ae-hesham/Temperature-Controlled-DC-Fan-PCB/hardware/schematics/Temperature-Controlled-DC-Fan-PCB_Schematics_BOM.pdf

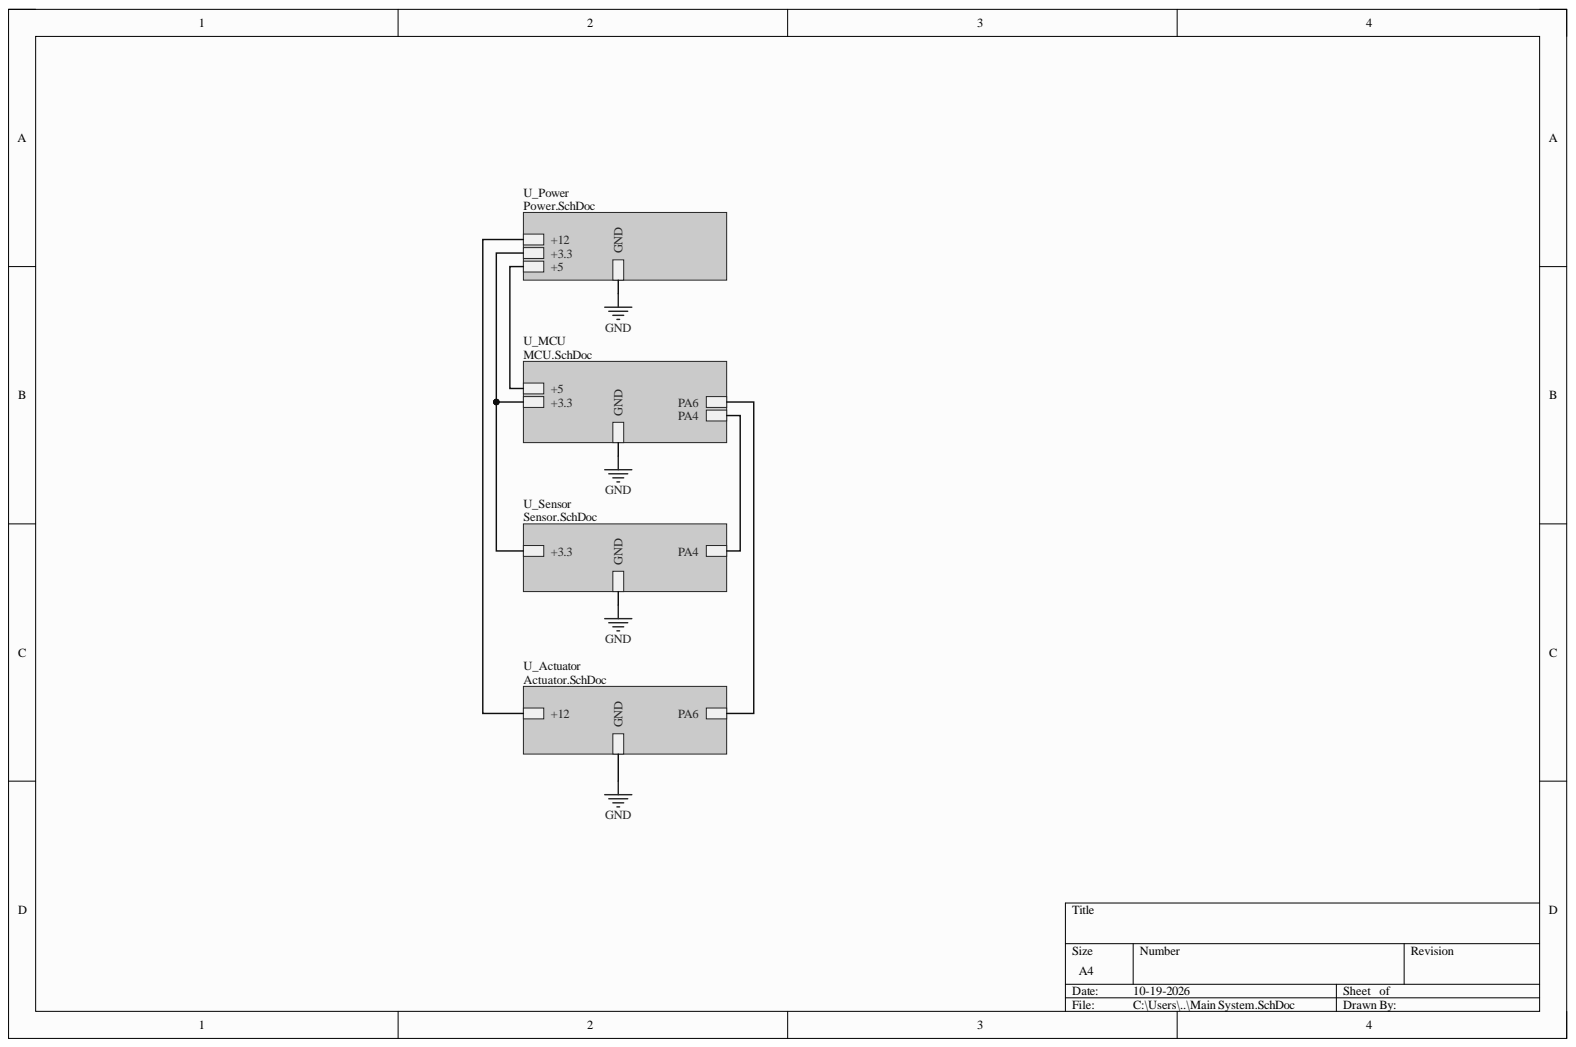
[picture p4: page 1]

Size A4 | Number | Revision

Date: 10-19-2026 | Sheet of
File: C:\Users\..\Main System.SchDoc | Drawn By:

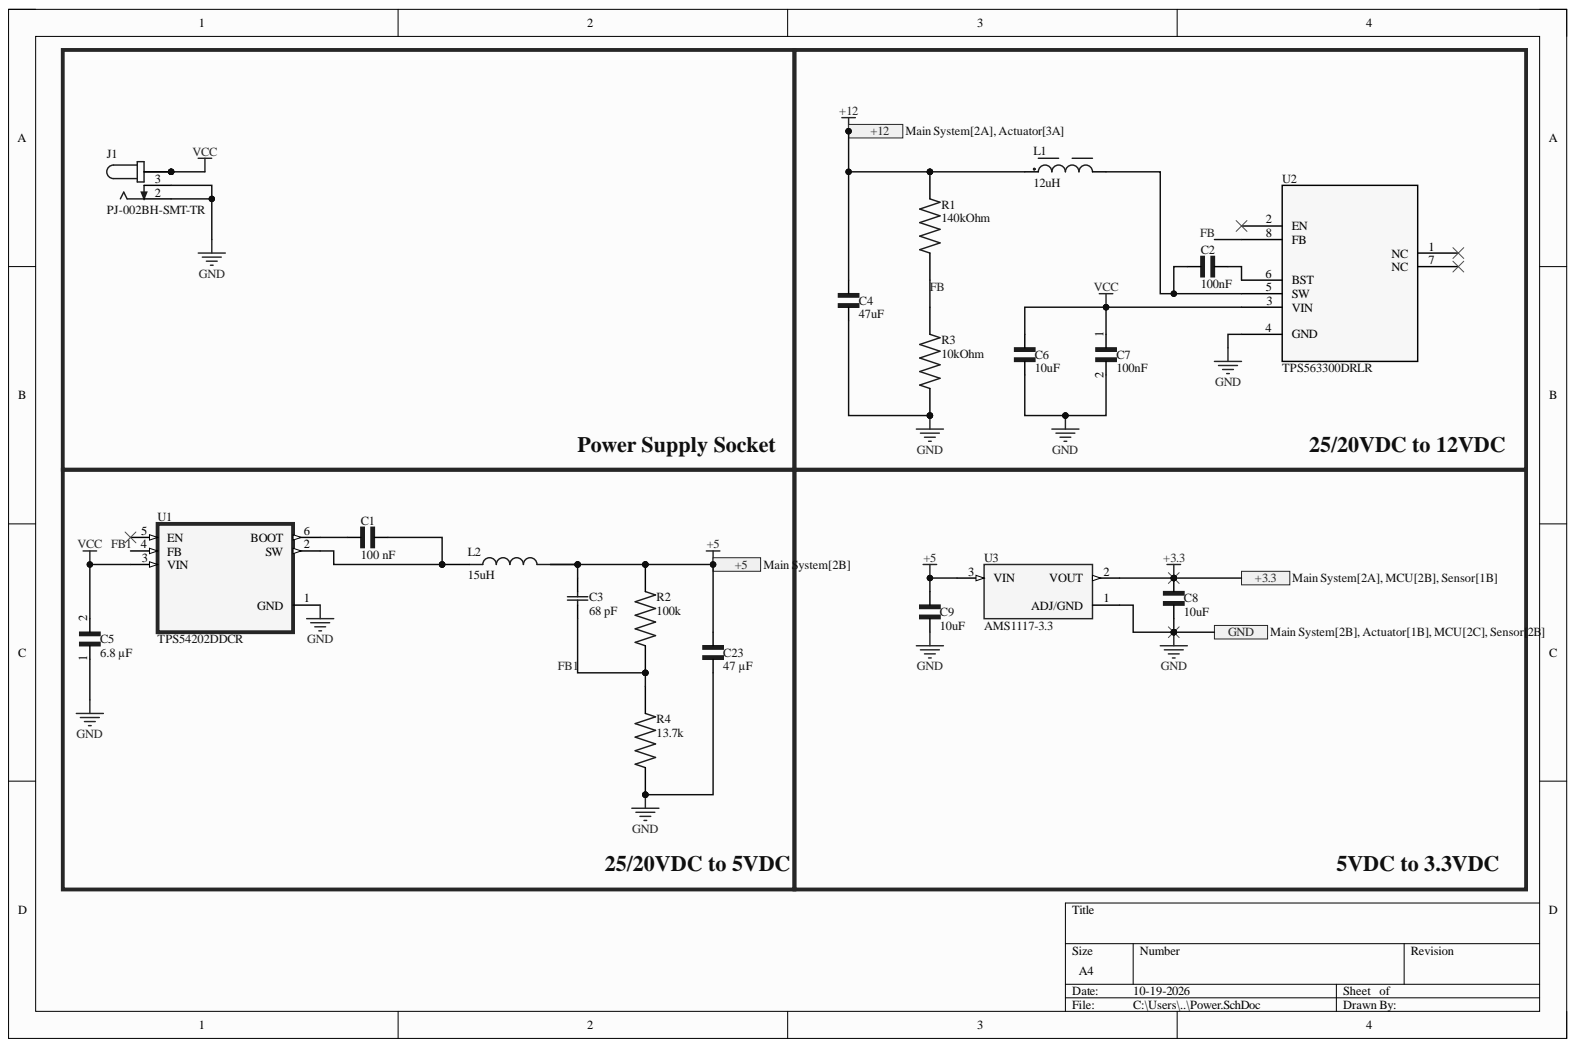
[picture p5: page 2]

Siz e A4 | Numb e r | R evisio n

Da te : 10-19-2 0 2 6 | She et of
File : C:\Use rs\. .\Pow e r . S c hD o c | Dr awn B y :

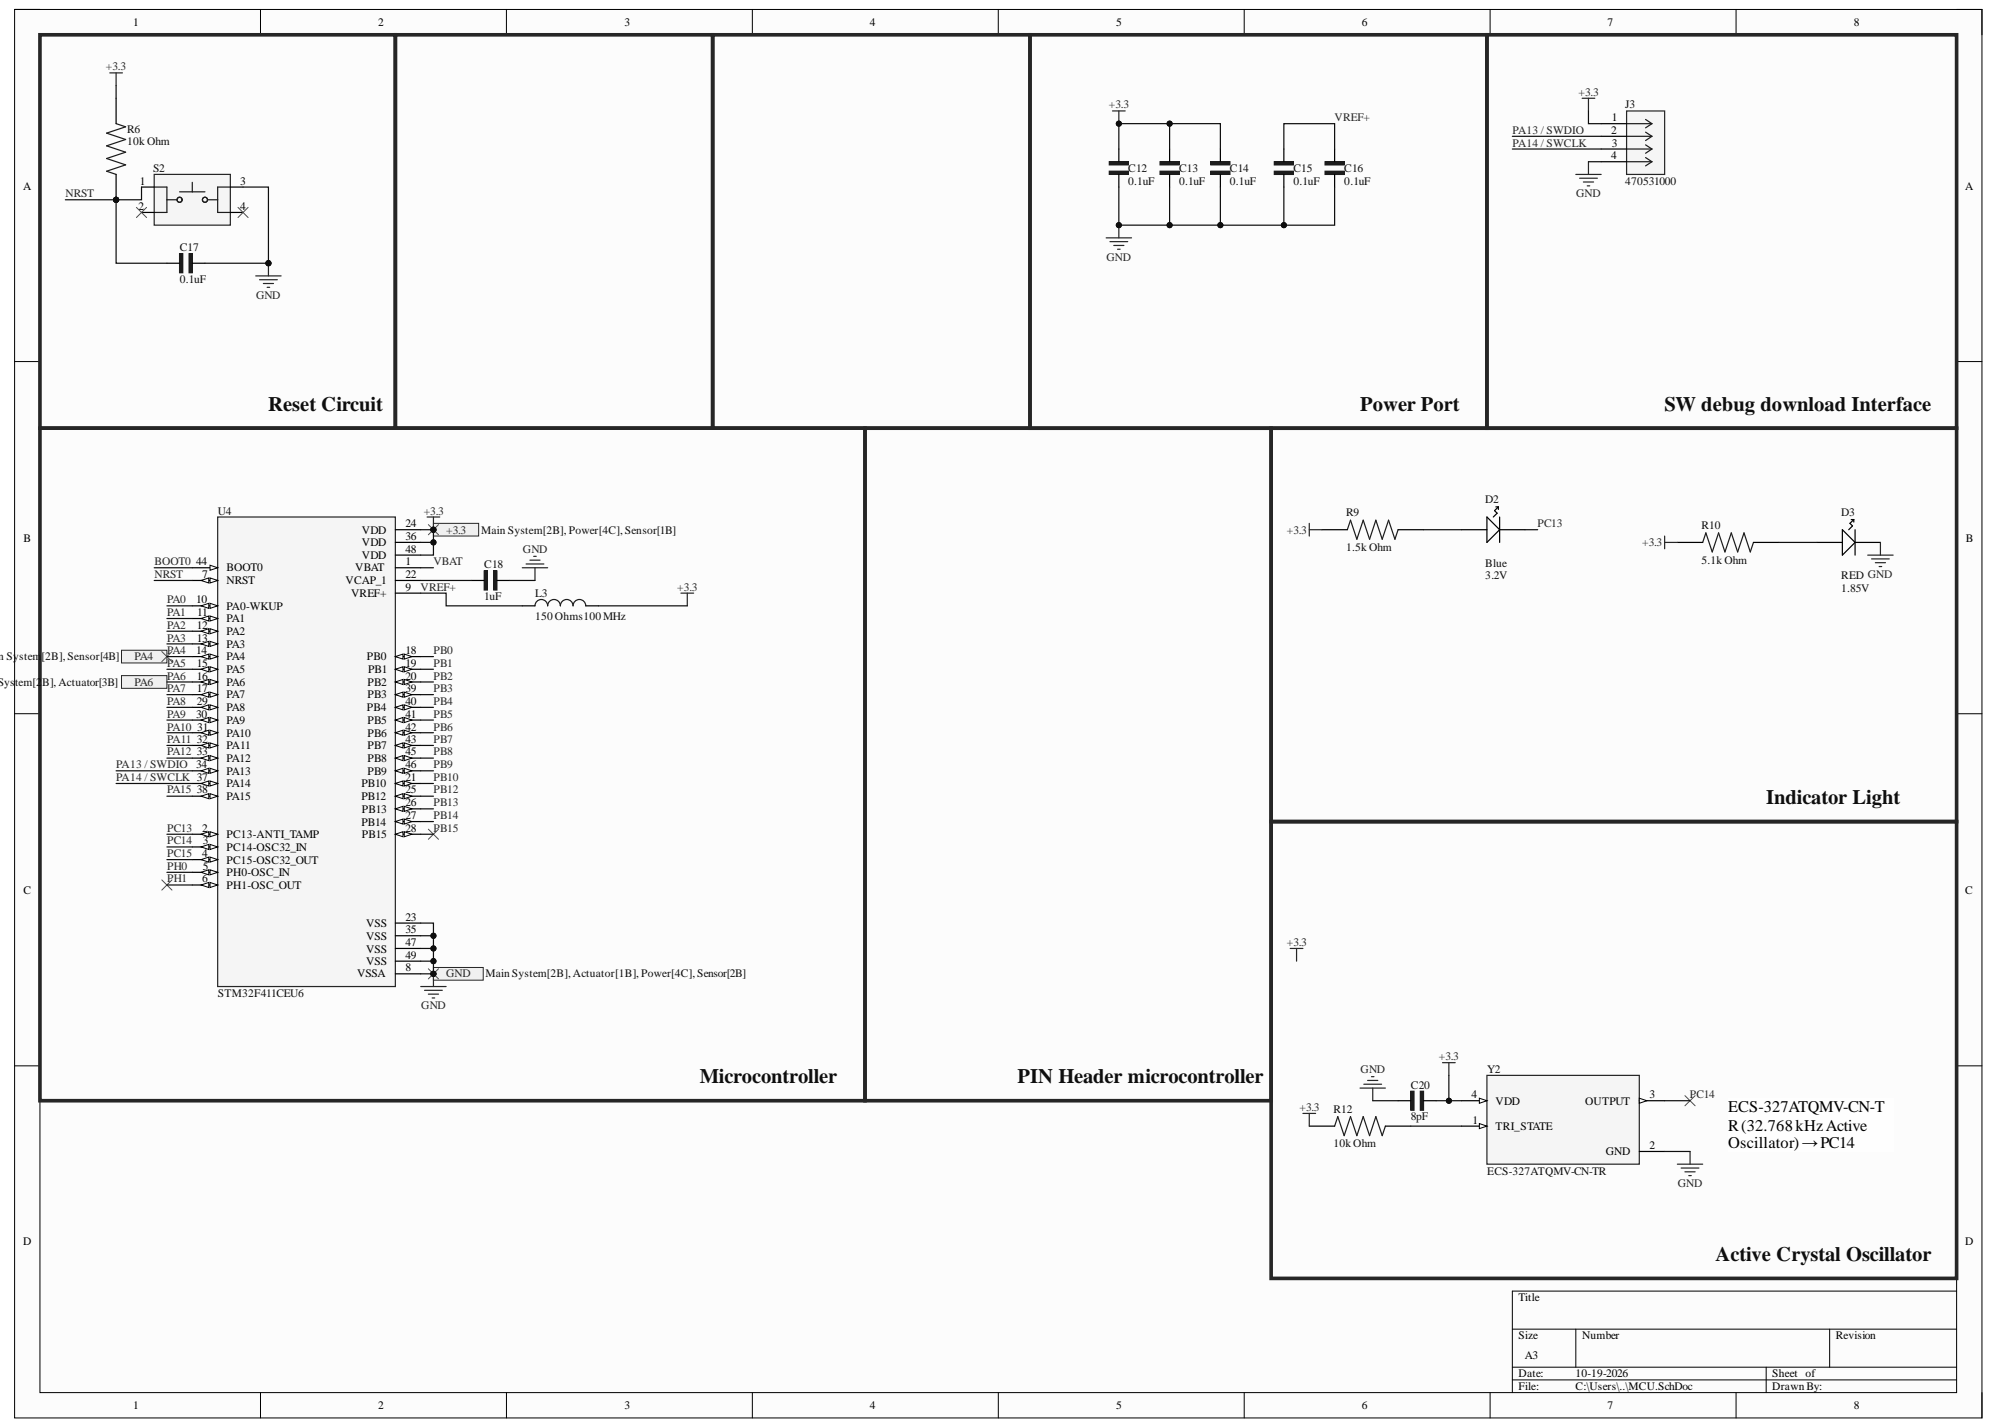
[picture p6: page 3]

SW debug download Interface

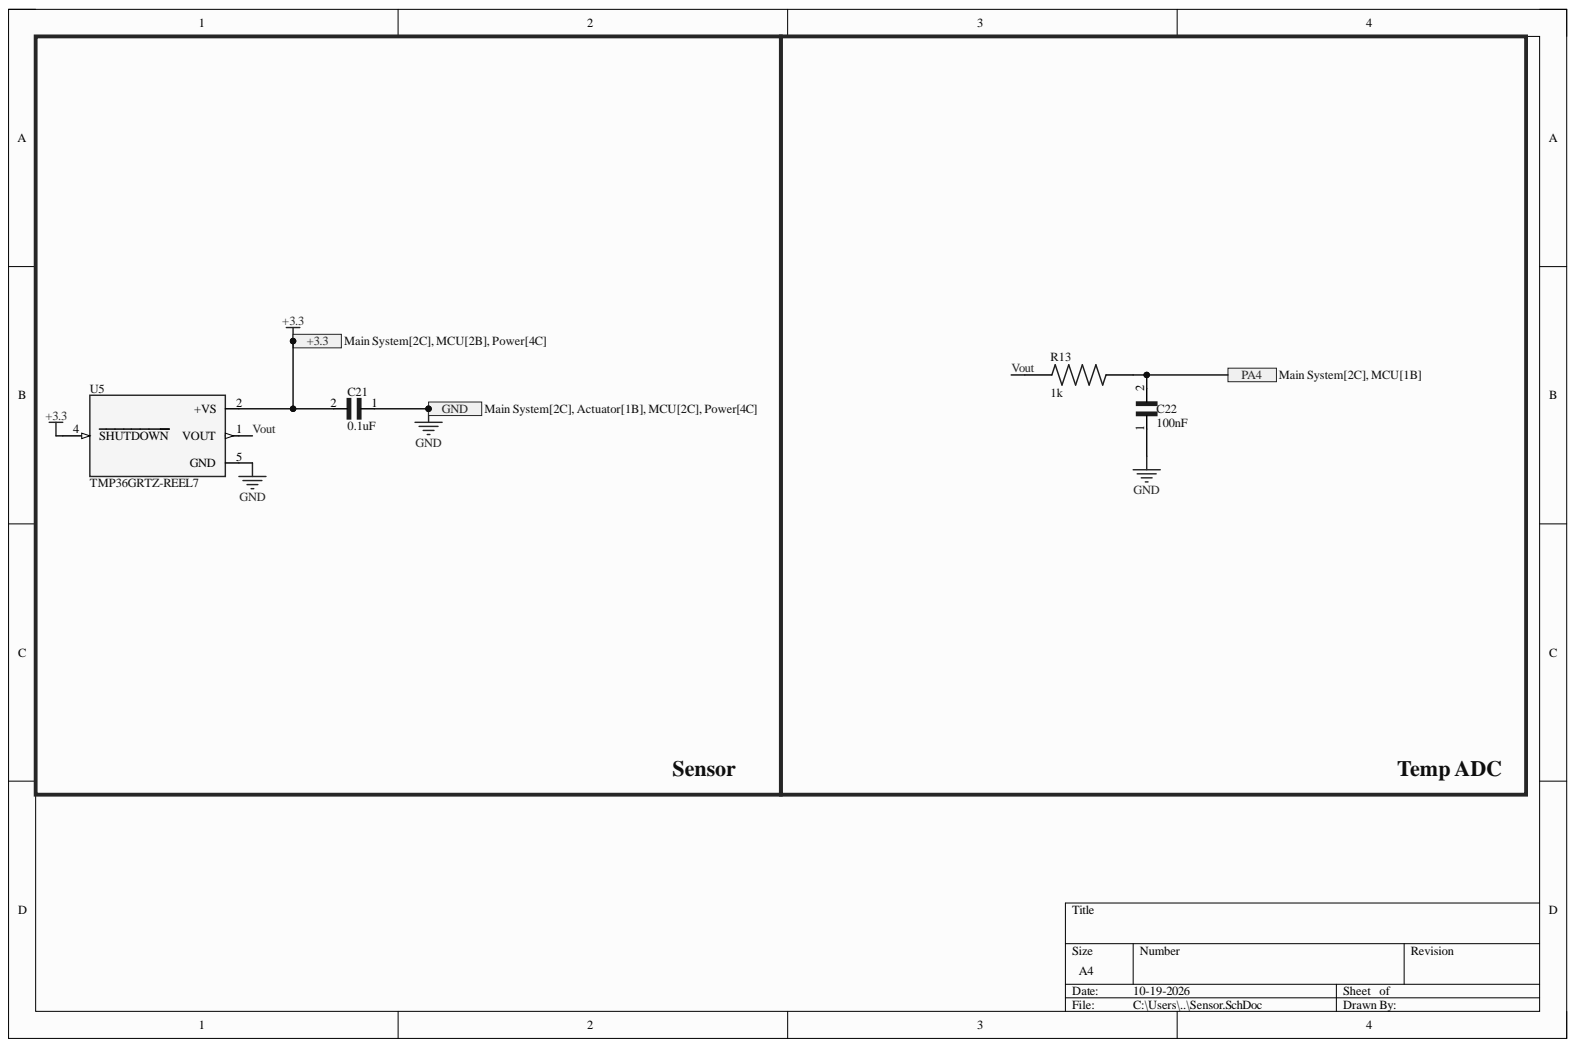
[picture p7: page 4]

Siz e A4 | Numb e r | R evisio n

Da te : 10-19-2 0 2 6 | She et of
File : C:\Use rs\. .\S enso r . S c hD o c | Dr awn B y :

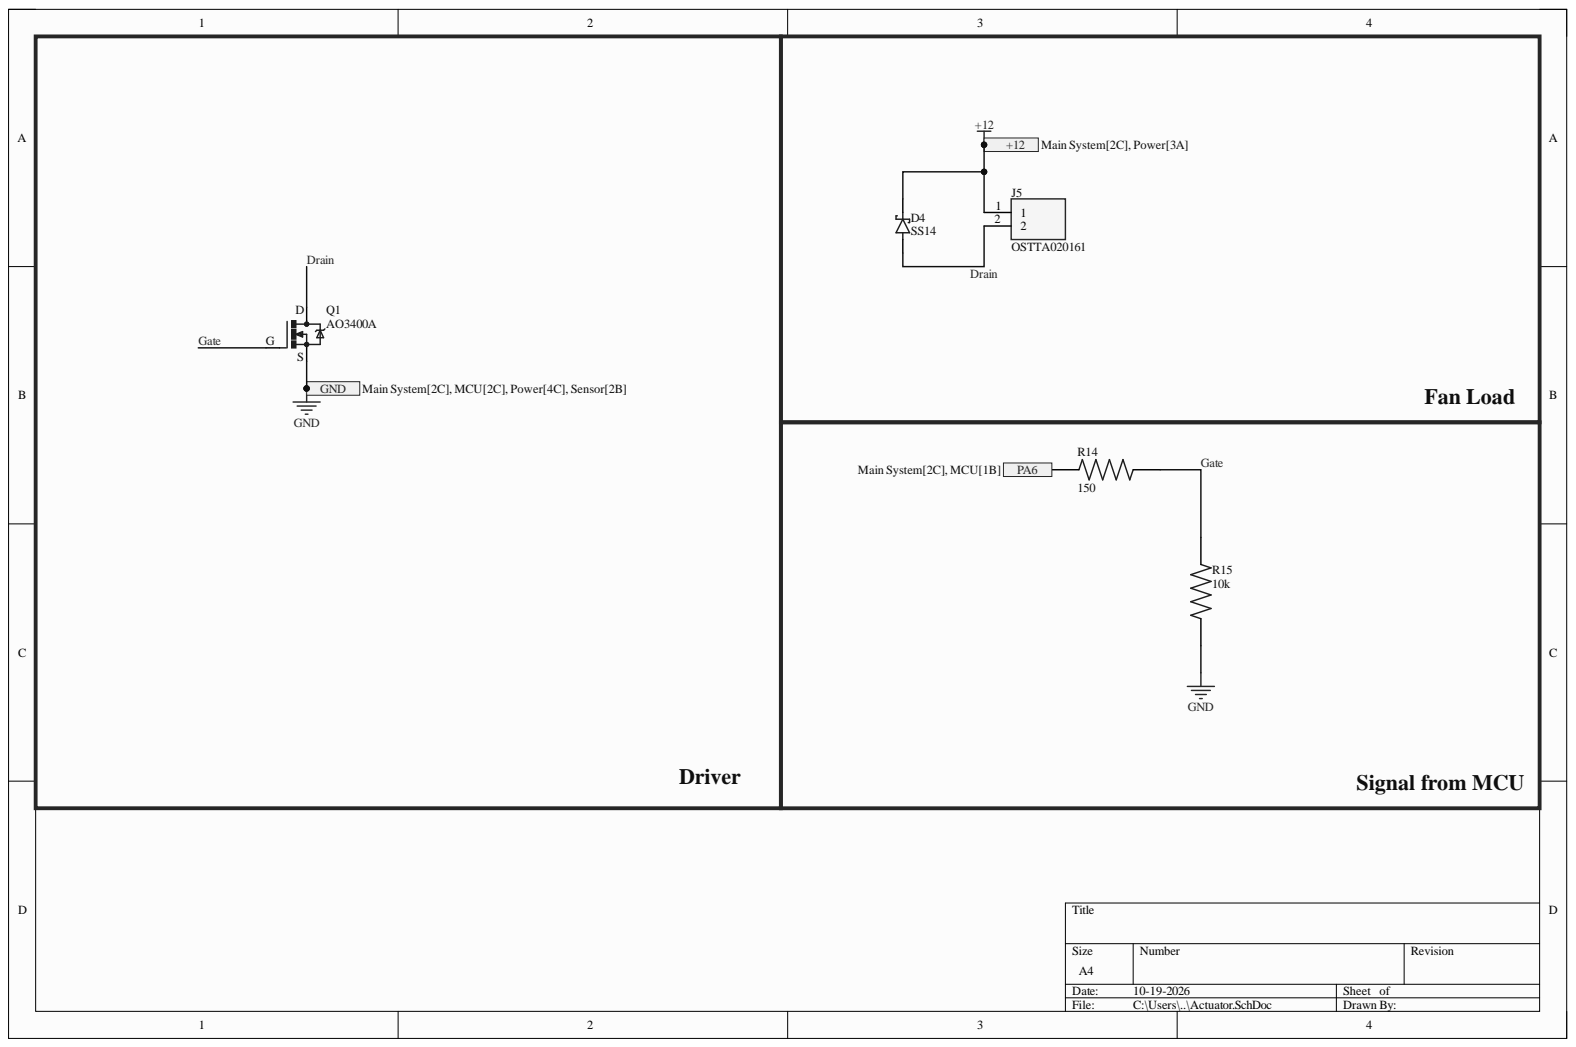
[picture p8: page 5]

Siz e A4 | Numb e r | R evisio n

Da te : 10-19-2 0 2 6 | She et of
File : C:\Use rs\. .\Actua tor . S c hD o c | Dr awn B y :

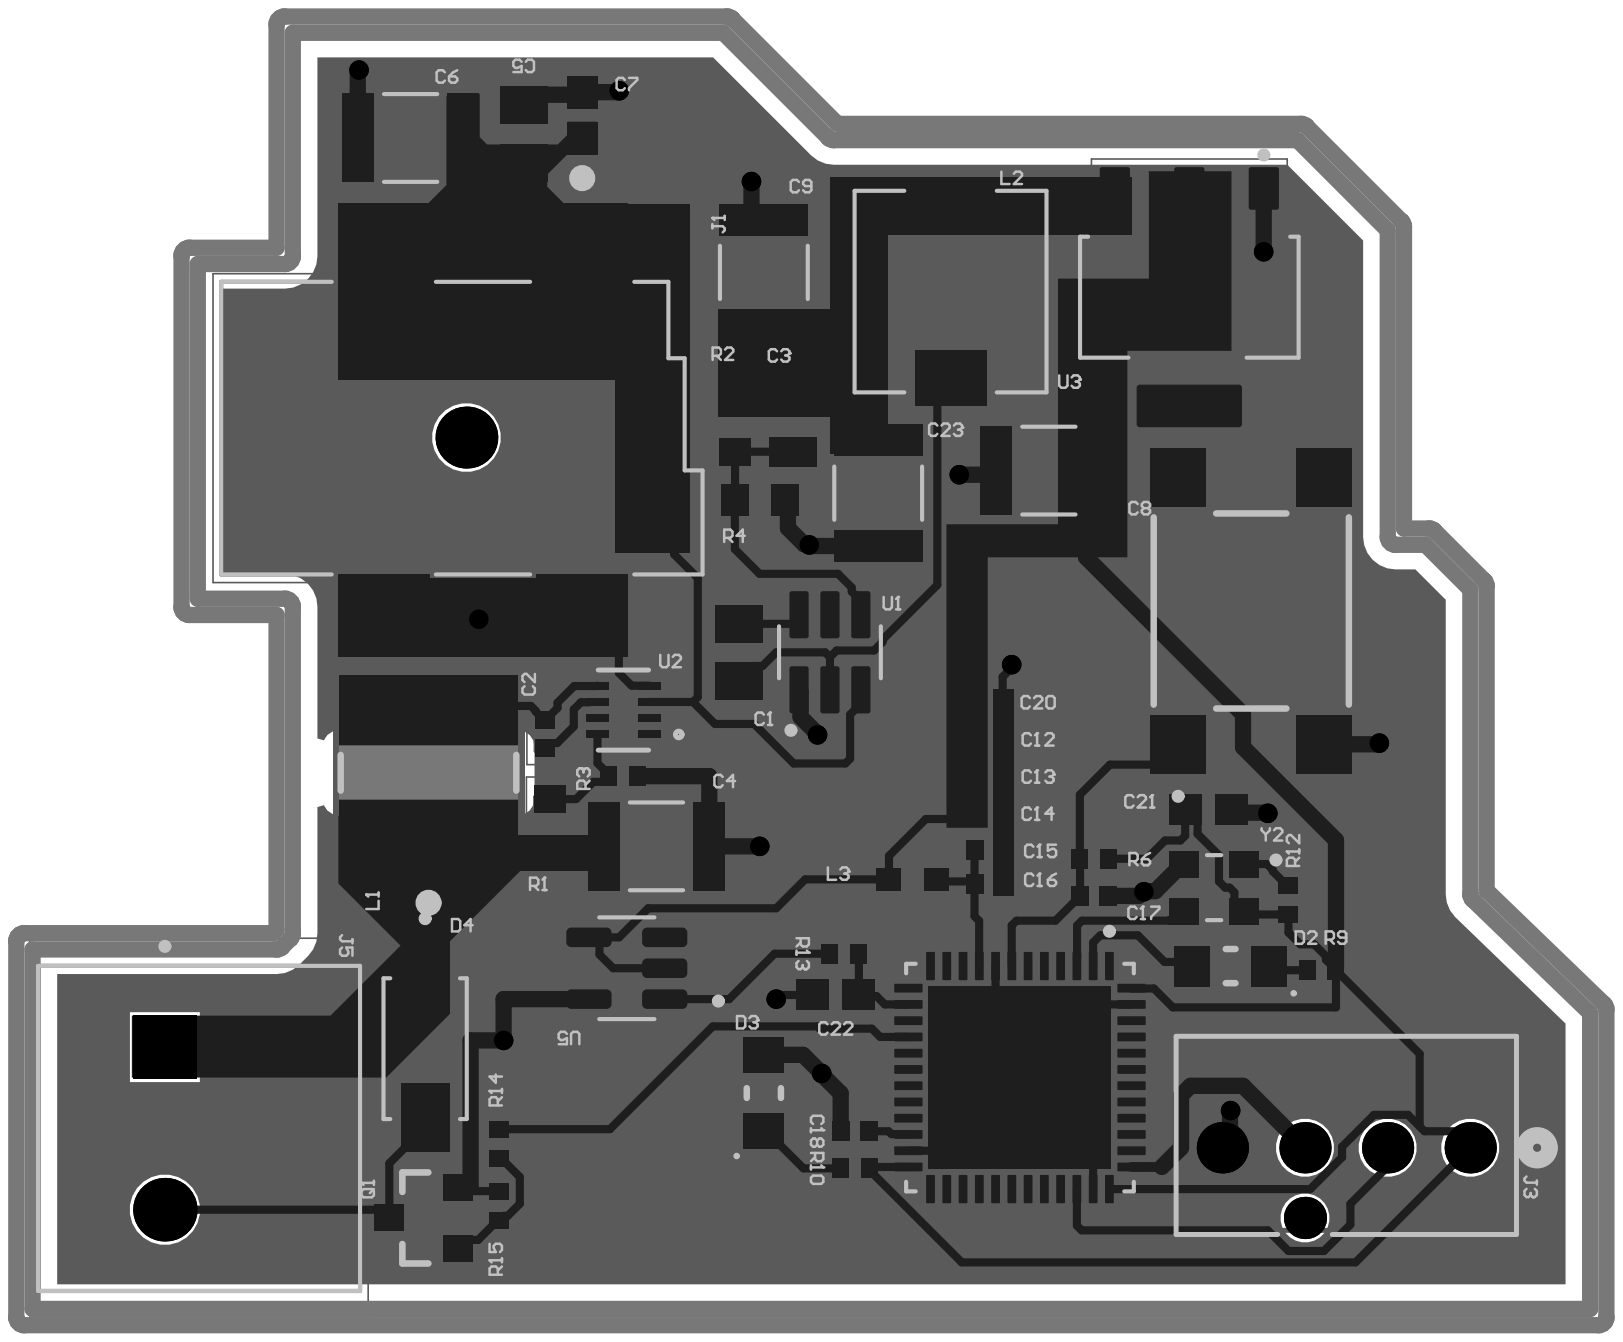
[picture p9: page 6]

Line# | Name | Description | Designator | Quantity | Manufacturer 1 | Manufacturer Part Number 1 | Manufacturer Lifecycle 1 | Supplier 1 | Supplier Part Number 1 | Supplier Unit Price 1 | Supplier Subtotal 1
| 100nF | 0.1ÂµFÂ±20%50VCeramic Capacitor X7R0805(2012Metric) | C1 | 1
| 100nF | GRM155R71A104KA01DCapCeramic 0.1uF10VDCX7R10%SMD0402 Paper T/RRoHS | C2 | 1
| 68pF | Capacitor;Ceramic;Cap;68.0pF;Tol+5%;SMT;Vol-Rtg50V;C0G| KEMET C0805C680J5GACTU | C3 | 1
| 47uF | SMDCapacitor X5R(EIA)with Capacitance: 47uFTol. 10%. RatedVoltage: 16Vdc | C4 | 1
| 6.8µF | 6.8Î¼FÂ±10%35Vé™¶ç“·ç”µå®¹å™¨ X5R0805ï¼ˆ 2012å…¬åˆ ¶ï¼‰ | C5 | 1
| 10uF | 10uF50V10%Multilayer Ceramic Capacitor X5R1210(3225Metric) | C6 | 1
| 100nF | 0.1ÂµFÂ±10%50VCeramic Capacitor X7R0603(1608Metric) | C7, C22 | 2
| 10uF | Cap=10µF Total DeratedCap=3.5µF VDC=25V ESR=5.85mΩ Package=0805 | C8, C9 | 2
| 0.1uF | GRM155R71A104KA01DCapCeramic 0.1uF10VDCX7R10%SMD0402 Paper T/RRoHS | C12, C13, C14, C15, C16, C17 | 6
| 1uF | GRM155R71A104KA01DCapCeramic 0.1uF10VDCX7R10%SMD0402 Paper T/RRoHS | C18 | 1
| 8pF | GRM155R71A104KA01DCapCeramic 0.1uF10VDCX7R10%SMD0402 Paper T/RRoHS | C20 | 1
| 0.1uF | 0.1ÂµFÂ±10%50VCeramic Capacitor X7R0603(1608Metric) | C21 | 1
| 47µF | SMDCapacitor X5R(EIA)with Capacitance: 47uFTol. 10%. RatedVoltage: 16Vdc | C23 | 1
| Kingbright BlueLED, 60 mcd120° 0805 | Kingbright BlueLED, 60mcd120° 0805 | D2 | 1
| Kingbright RedLED, 100mcd120° 0805 | Kingbright RedLED, 100mcd120° 0805 | D3 | 1
| SS14 | 1A, 40V, SchottkyRectifier | D4 | 1
| PJ-002BH-SMT-TR | 2.5x6.5mm, 5.0A, Horizontal, SurfaceMount (SMT), Dc Power Jack Connector | J1 | 1
| 470531000 | ConnWire toBoardHDR4POS2.54mmSolder STThru-HoleKKÂ®Bag | J3 | 1
| OSTTA020161 | | J5 | 1
| 12uH | FIXEDIND12UH2A110MOHMSMD | L1 | 1
| 15uH | IndPower ShieldedWirewound15uH20%100KHzFerrite 2ABlister Plastic T/R | L2 | 1
| 150Ohms100MHz | 150Ohms@100MHz1Power, Signal LineFerriteBead0402(1005Metric) 100mA300mOhm | L3 | 1
| AO3400A | N-Channel 30V5.8A(Ta)1.4W(Ta)SurfaceMount SOT-23 | Q1 | 1
| 140kOhm | 140kOhmsÂ±1%0.1W, 1/10WChipResistor 0603(1608Metric)Automotive AEC-Q200ThickFilm | R1 | 1
| 100k | 140kOhmsÂ±1%0.1W, 1/10WChipResistor 0603(1608Metric)Automotive AEC-Q200ThickFilm | R2 | 1
| 10kOhm | Resistor;ThickFilm;10Kilohms;0.063W;1%;SMT;0402;TCR37 ppm/DegC;TapeandReel | VishayDaleCRCW040210K0FKED | R3 | 1
| 13.7k | 140kOhmsÂ±1%0.1W, 1/10WChipResistor 0603(1608Metric)Automotive AEC-Q200ThickFilm | R4 | 1
| 10kOhm | Resistor;ThickFilm;10Kilohms;0.063W;1%;SMT;0402;TCR37 ppm/DegC;TapeandReel | VishayDaleCRCW040210K0FKED | R6, R12 | 2
| 1.5kOhm | Resistor;ThickFilm;10Kilohms;0.063W;1%;SMT;0402;TCR37 ppm/DegC;TapeandReel | VishayDaleCRCW040210K0FKED | R9 | 1
| 5.1kOhm | Resistor;ThickFilm;10Kilohms;0.063W;1%;SMT;0402;TCR37 ppm/DegC;TapeandReel | VishayDaleCRCW040210K0FKED | R10 | 1
| 1k | Resistor;ThickFilm;10Kilohms;0.063W;1%;SMT;0402;TCR37 ppm/DegC;TapeandReel | VishayDaleCRCW040210K0FKED | R13 | 1
| 150 | Resistor;ThickFilm;10Kilohms;0.063W;1%;SMT;0402;TCR37 ppm/DegC;TapeandReel | VishayDaleCRCW040210K0FKED | R14 | 1
| 10k | Resistor;ThickFilm;10Kilohms;0.063W;1%;SMT;0402;TCR37 ppm/DegC;TapeandReel | VishayDaleCRCW040210K0FKED | R15 | 1
| SWT0310-043025GSA_REVA | 6mmx6mmGull WingTactileSwitch | S2 | 1
| TPS54202DDCR | 4.5Vto28VInput, 2AOutput, EMIFriendlySynchronousStep-DownConverter | U1 | 1
| TPS563300DRLR | 3.8-Vto28-VInput, 3-Asynchronousbuck converter inSOT-583package8-SOT-5X3-40to150 | U2 | 1
| AMS1117-3.3 | Linear VoltageRegulator ICPositiveFixed1Output 1ASOT-223-3L | U3 | 1
| STM32F411CEU6 | High-performanceaccessline, ARMCortex-M4corewith DSPandFPU, 512 KbytesFlash, 100MHzCPU, ARTAccelerator | U4 | 1
| TMP36GRTZ-REEL7 | VoltageOutput TemperatureSensors | U5 | 1
| ECS-327ATQMV-CN-TR | 32.768kHzXO(Standard)CMOSOscillator 1.62V~3.63VEnable/Disable4-SMD, NoLead | Y2 | 1
