ae-hesham/Temperature-Controlled-DC-Fan-PCB/(list of files, drawings)

Other design files:
hardware/PCB/Temperature-Controlled DC Fan PCB.PcbDoc
hardware/schematics/Actuator.SchDoc
hardware/schematics/Main System.SchDoc
hardware/schematics/MCU.SchDoc
hardware/schematics/Power.SchDoc
hardware/schematics/Sensor.SchDoc
