ae-hesham/Temperature-Controlled-DC-Fan-PCB/(commit log)

2026-10-22 Create bom
2026-10-22 Create gerber
2026-10-22 Create pcb
2026-10-22 Create schematics
