ae-hesham/Temperature-Controlled-DC-Fan-PCB/(notices)

Notices in the files:
README.md:
License: MIT
